kpzip/IEEEClock/README.md

# IEEEClock
Back to the future style clock
