kpzip/IEEEClock/new/pcb/1.1/clock.kicad_pcb

## KiCad design new/pcb/1.1/clock.kicad_pcb (2025-06-02)

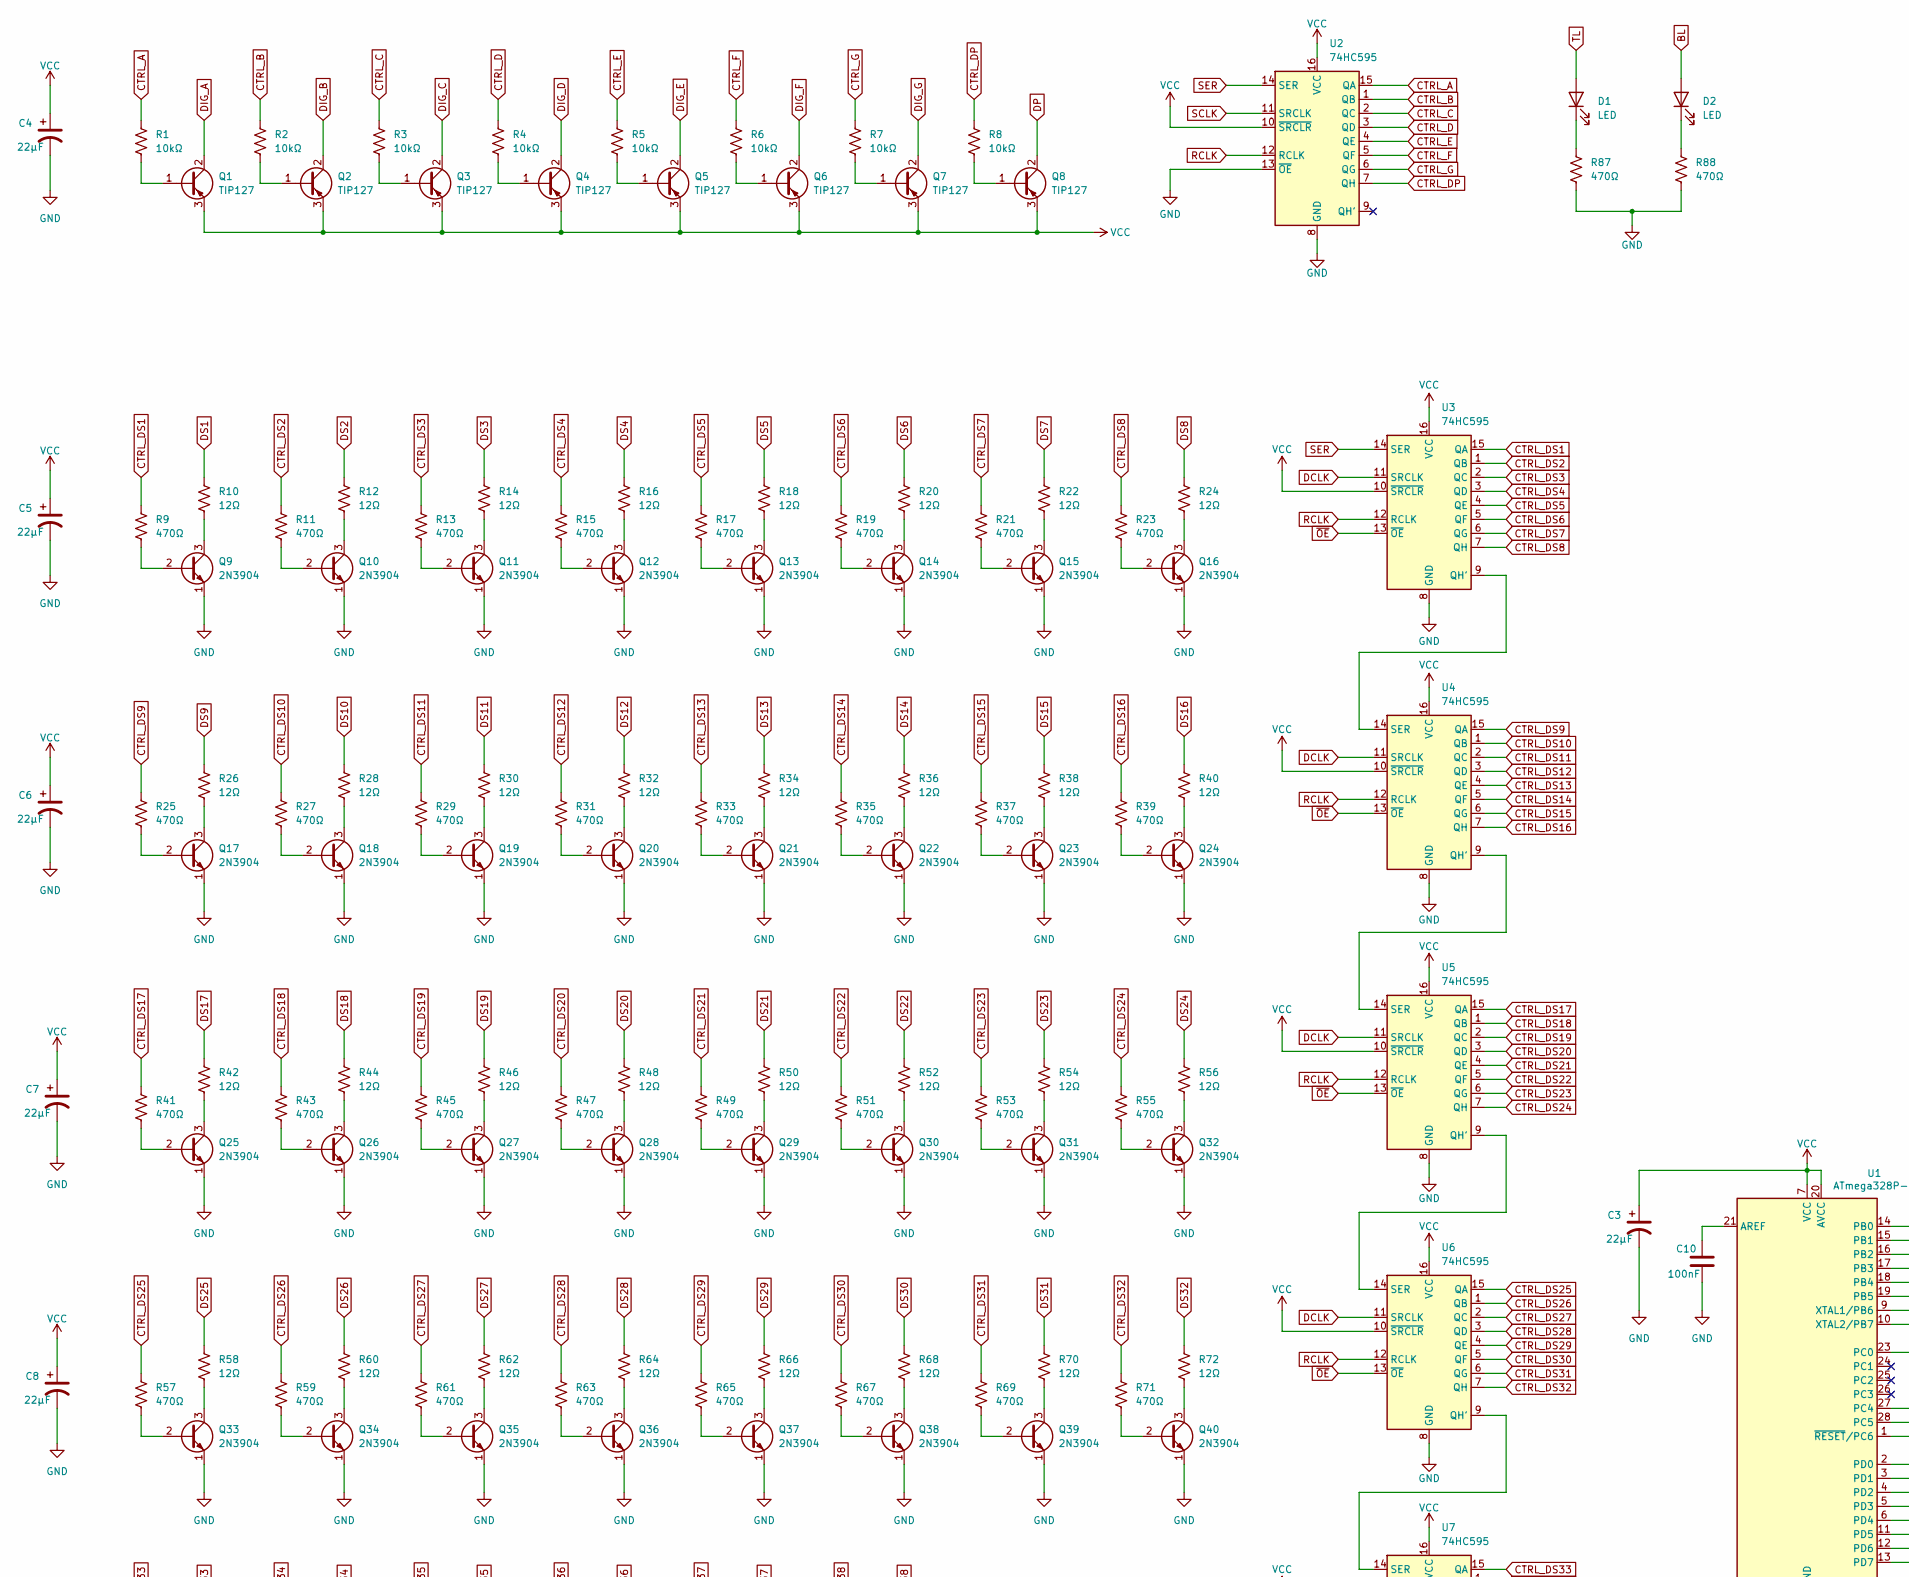
[picture p1: schematic clock.kicad_sch, IEEE Clock, part in row 1, column 1]

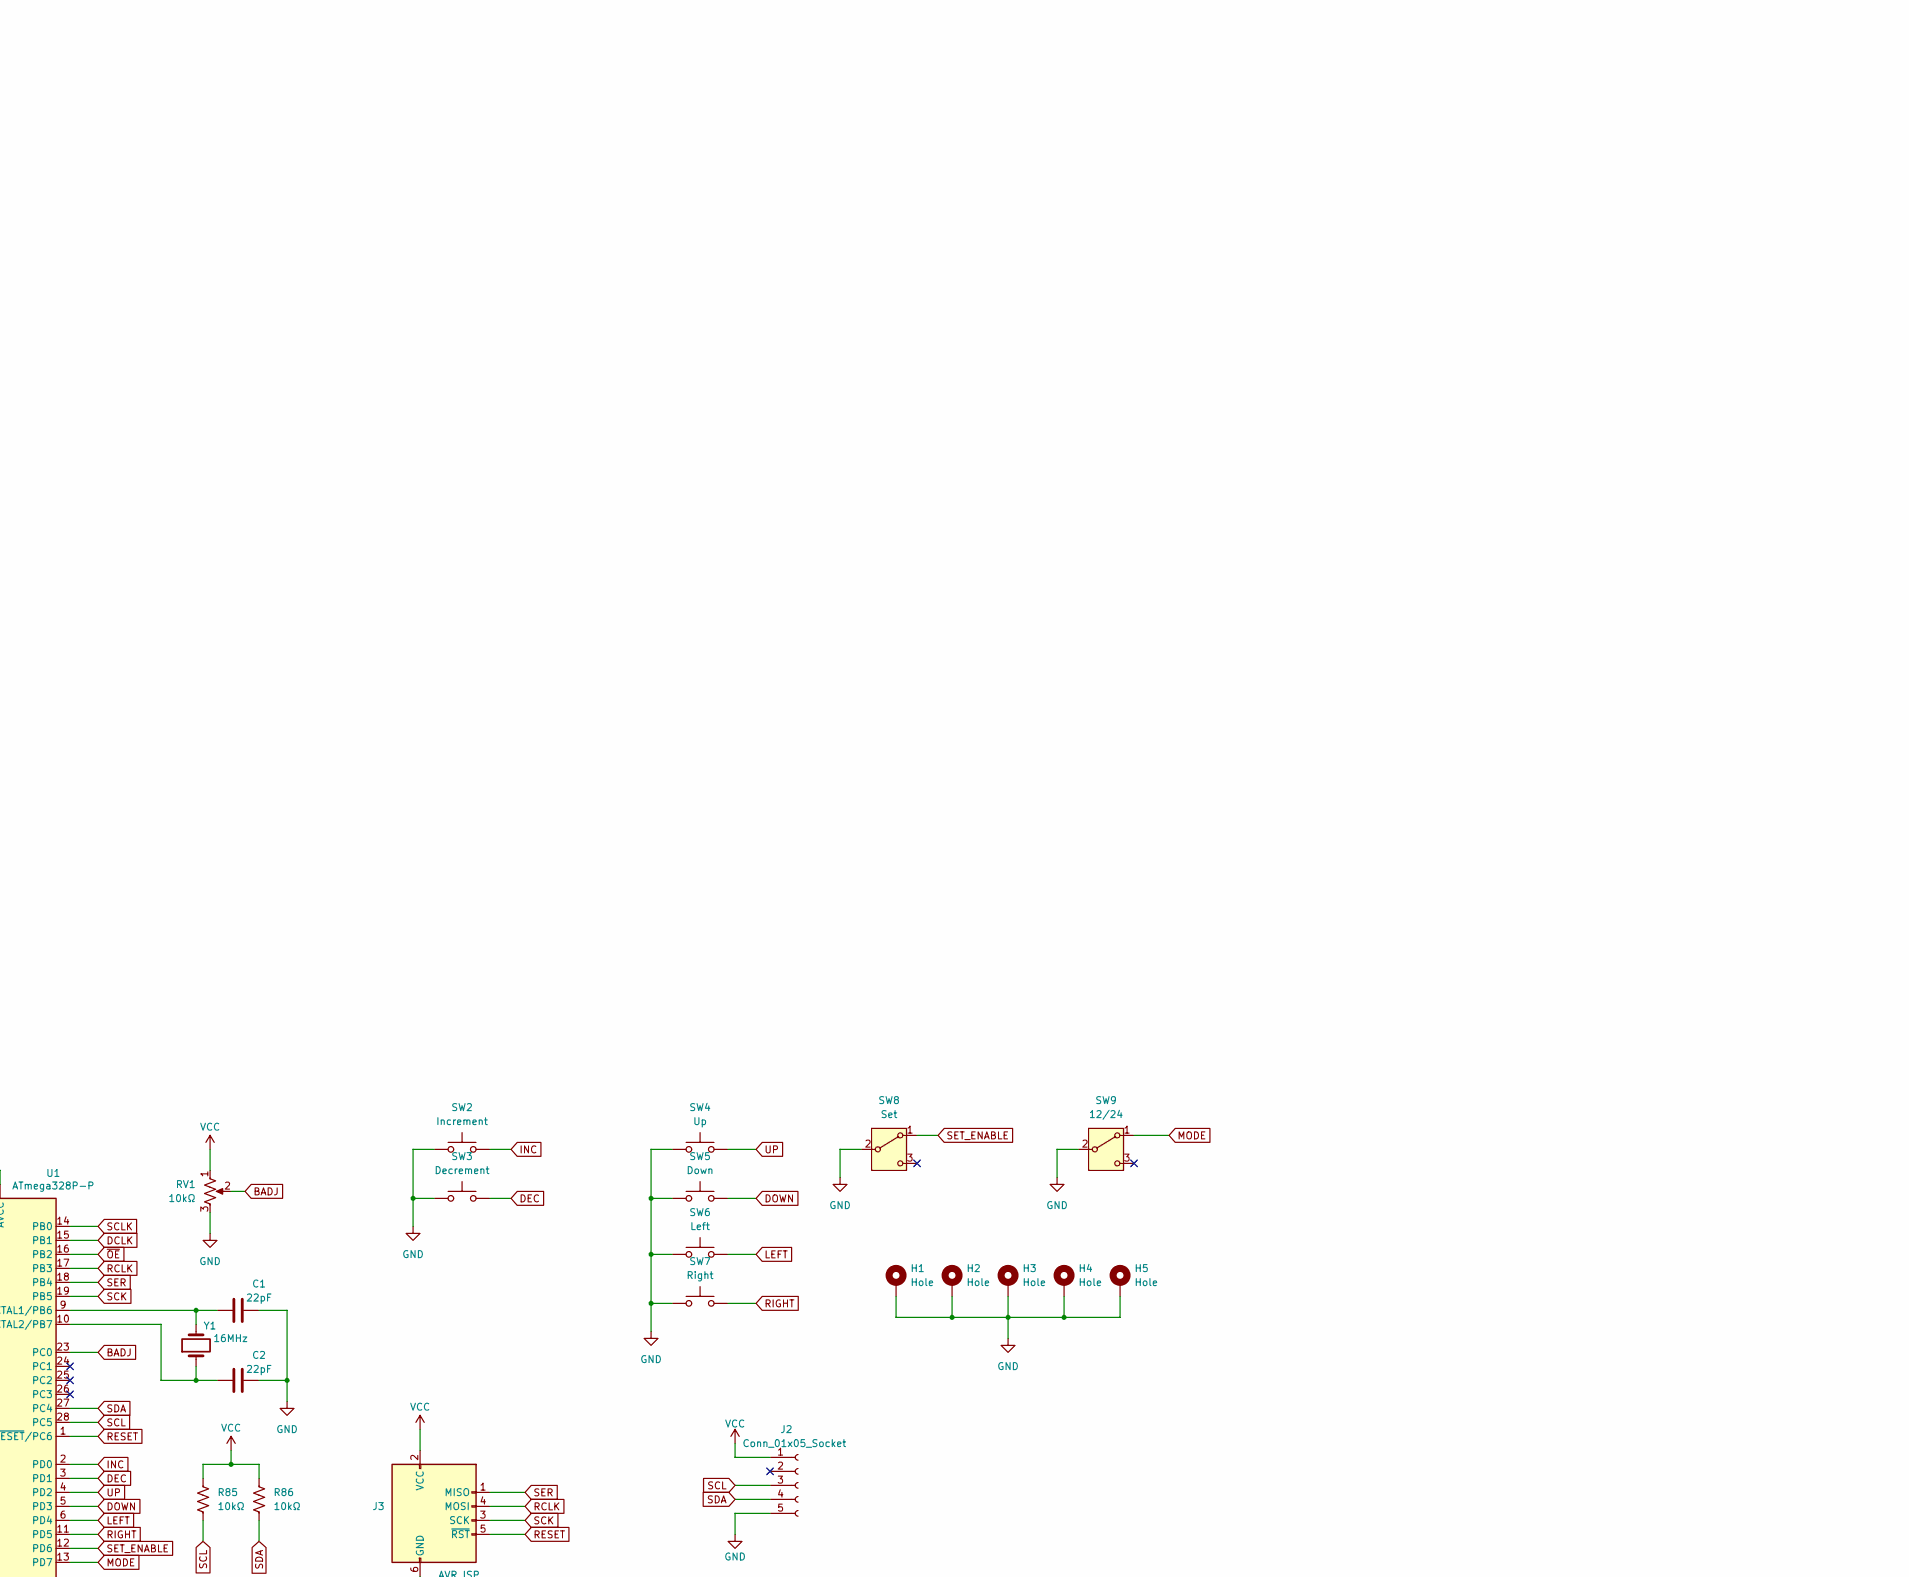
[picture p2: schematic clock.kicad_sch, IEEE Clock, part in row 1, column 2]

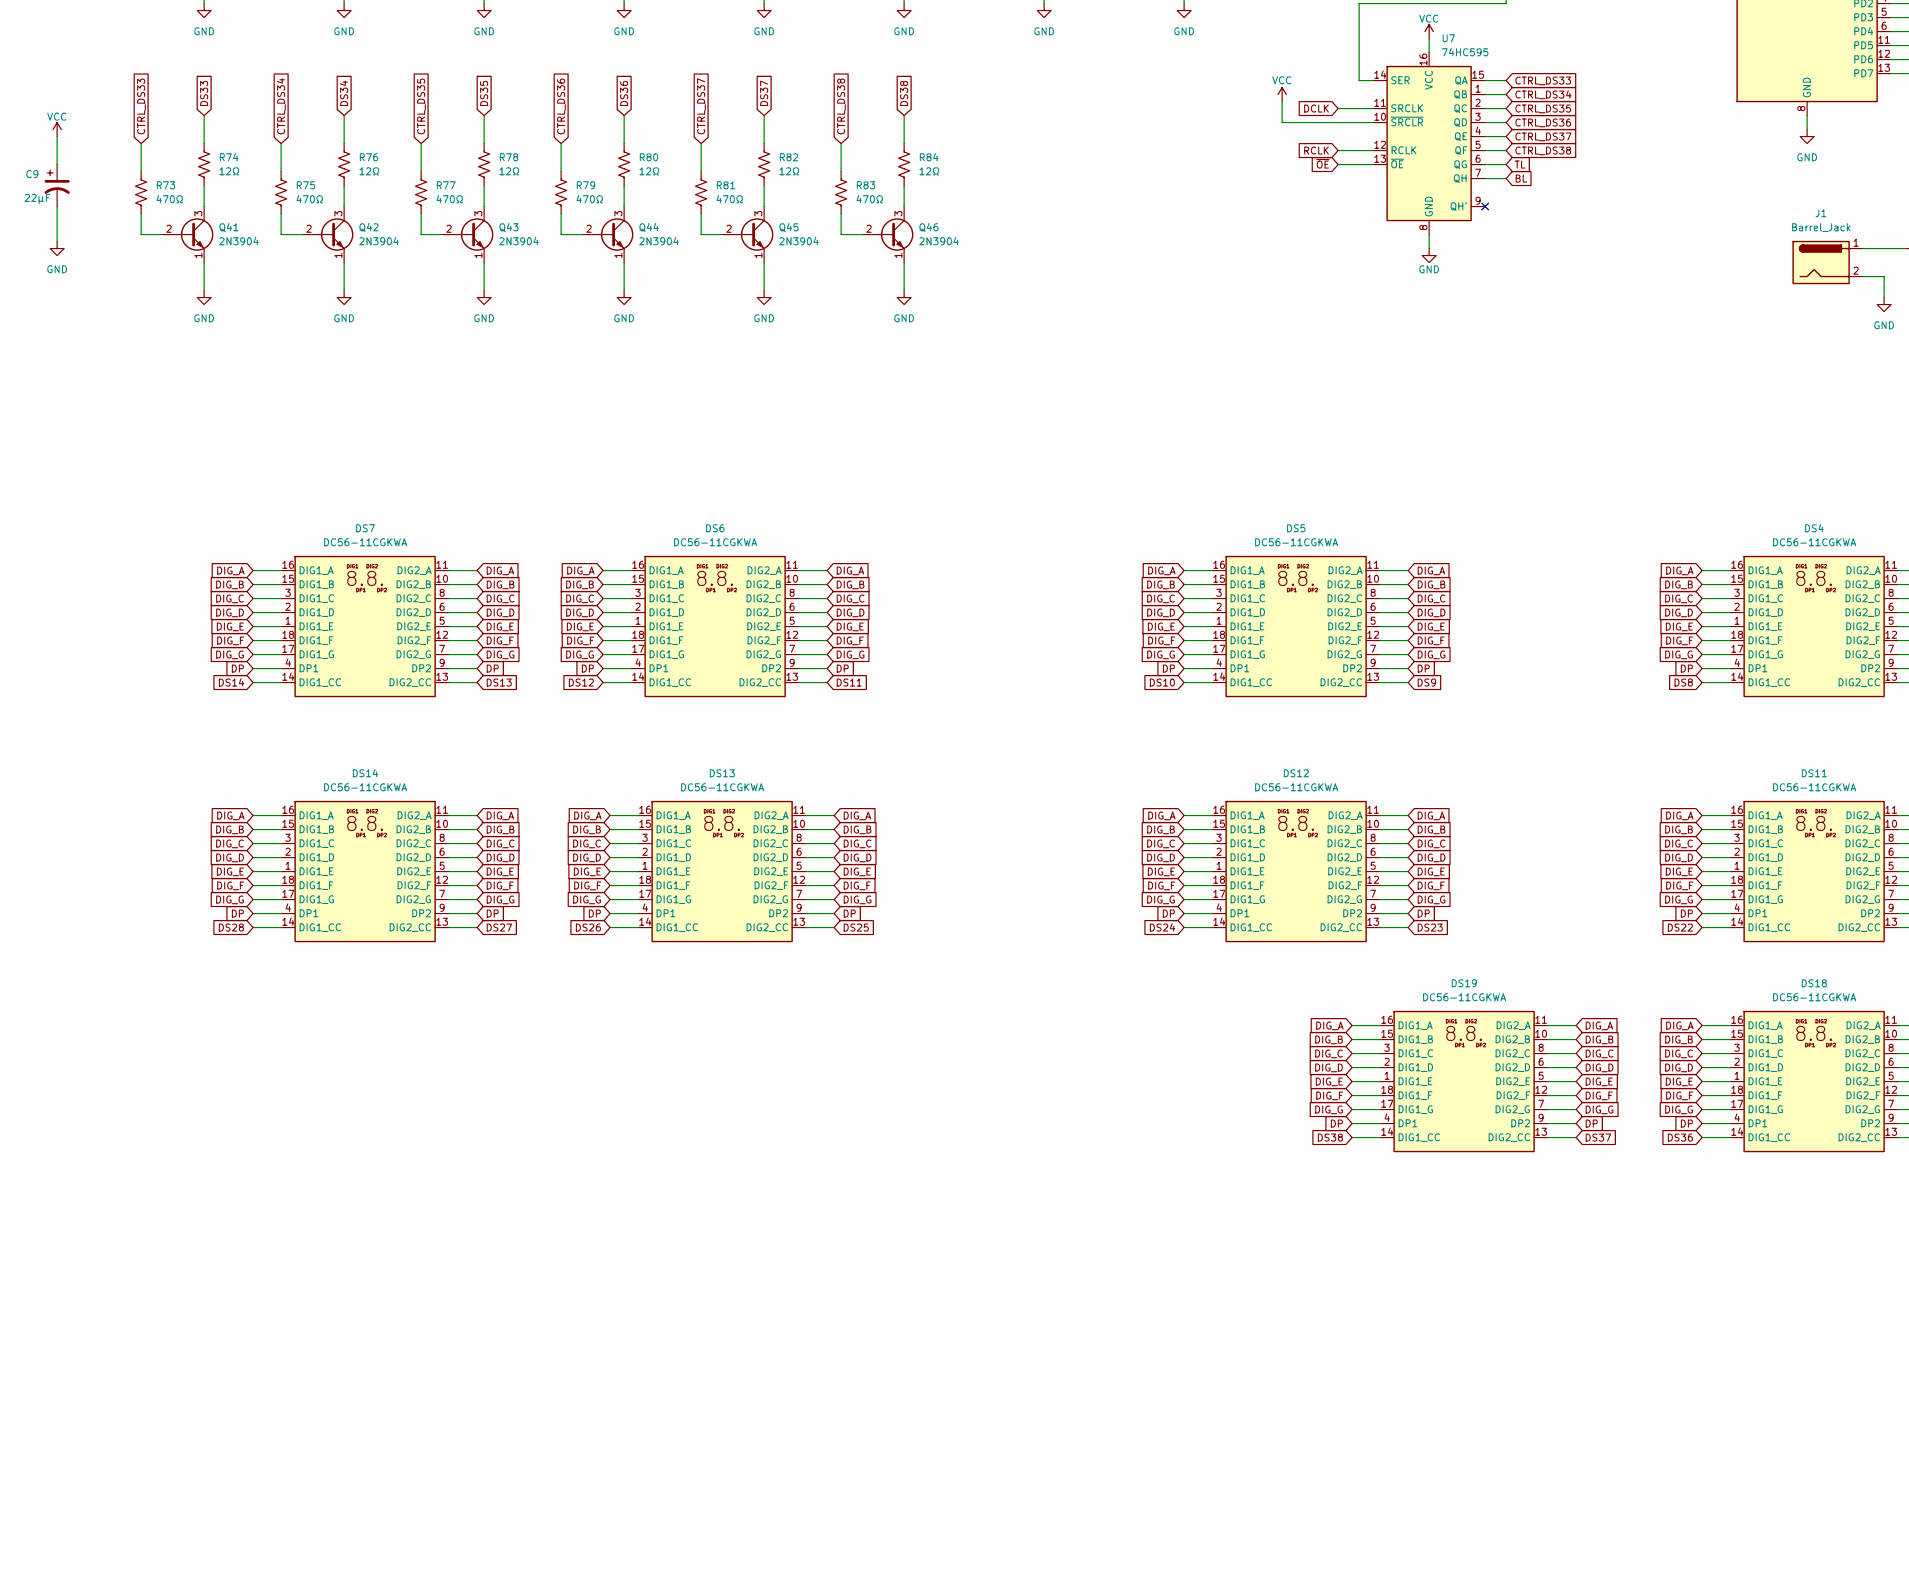
[picture p3: schematic clock.kicad_sch, IEEE Clock, part in row 2, column 1]

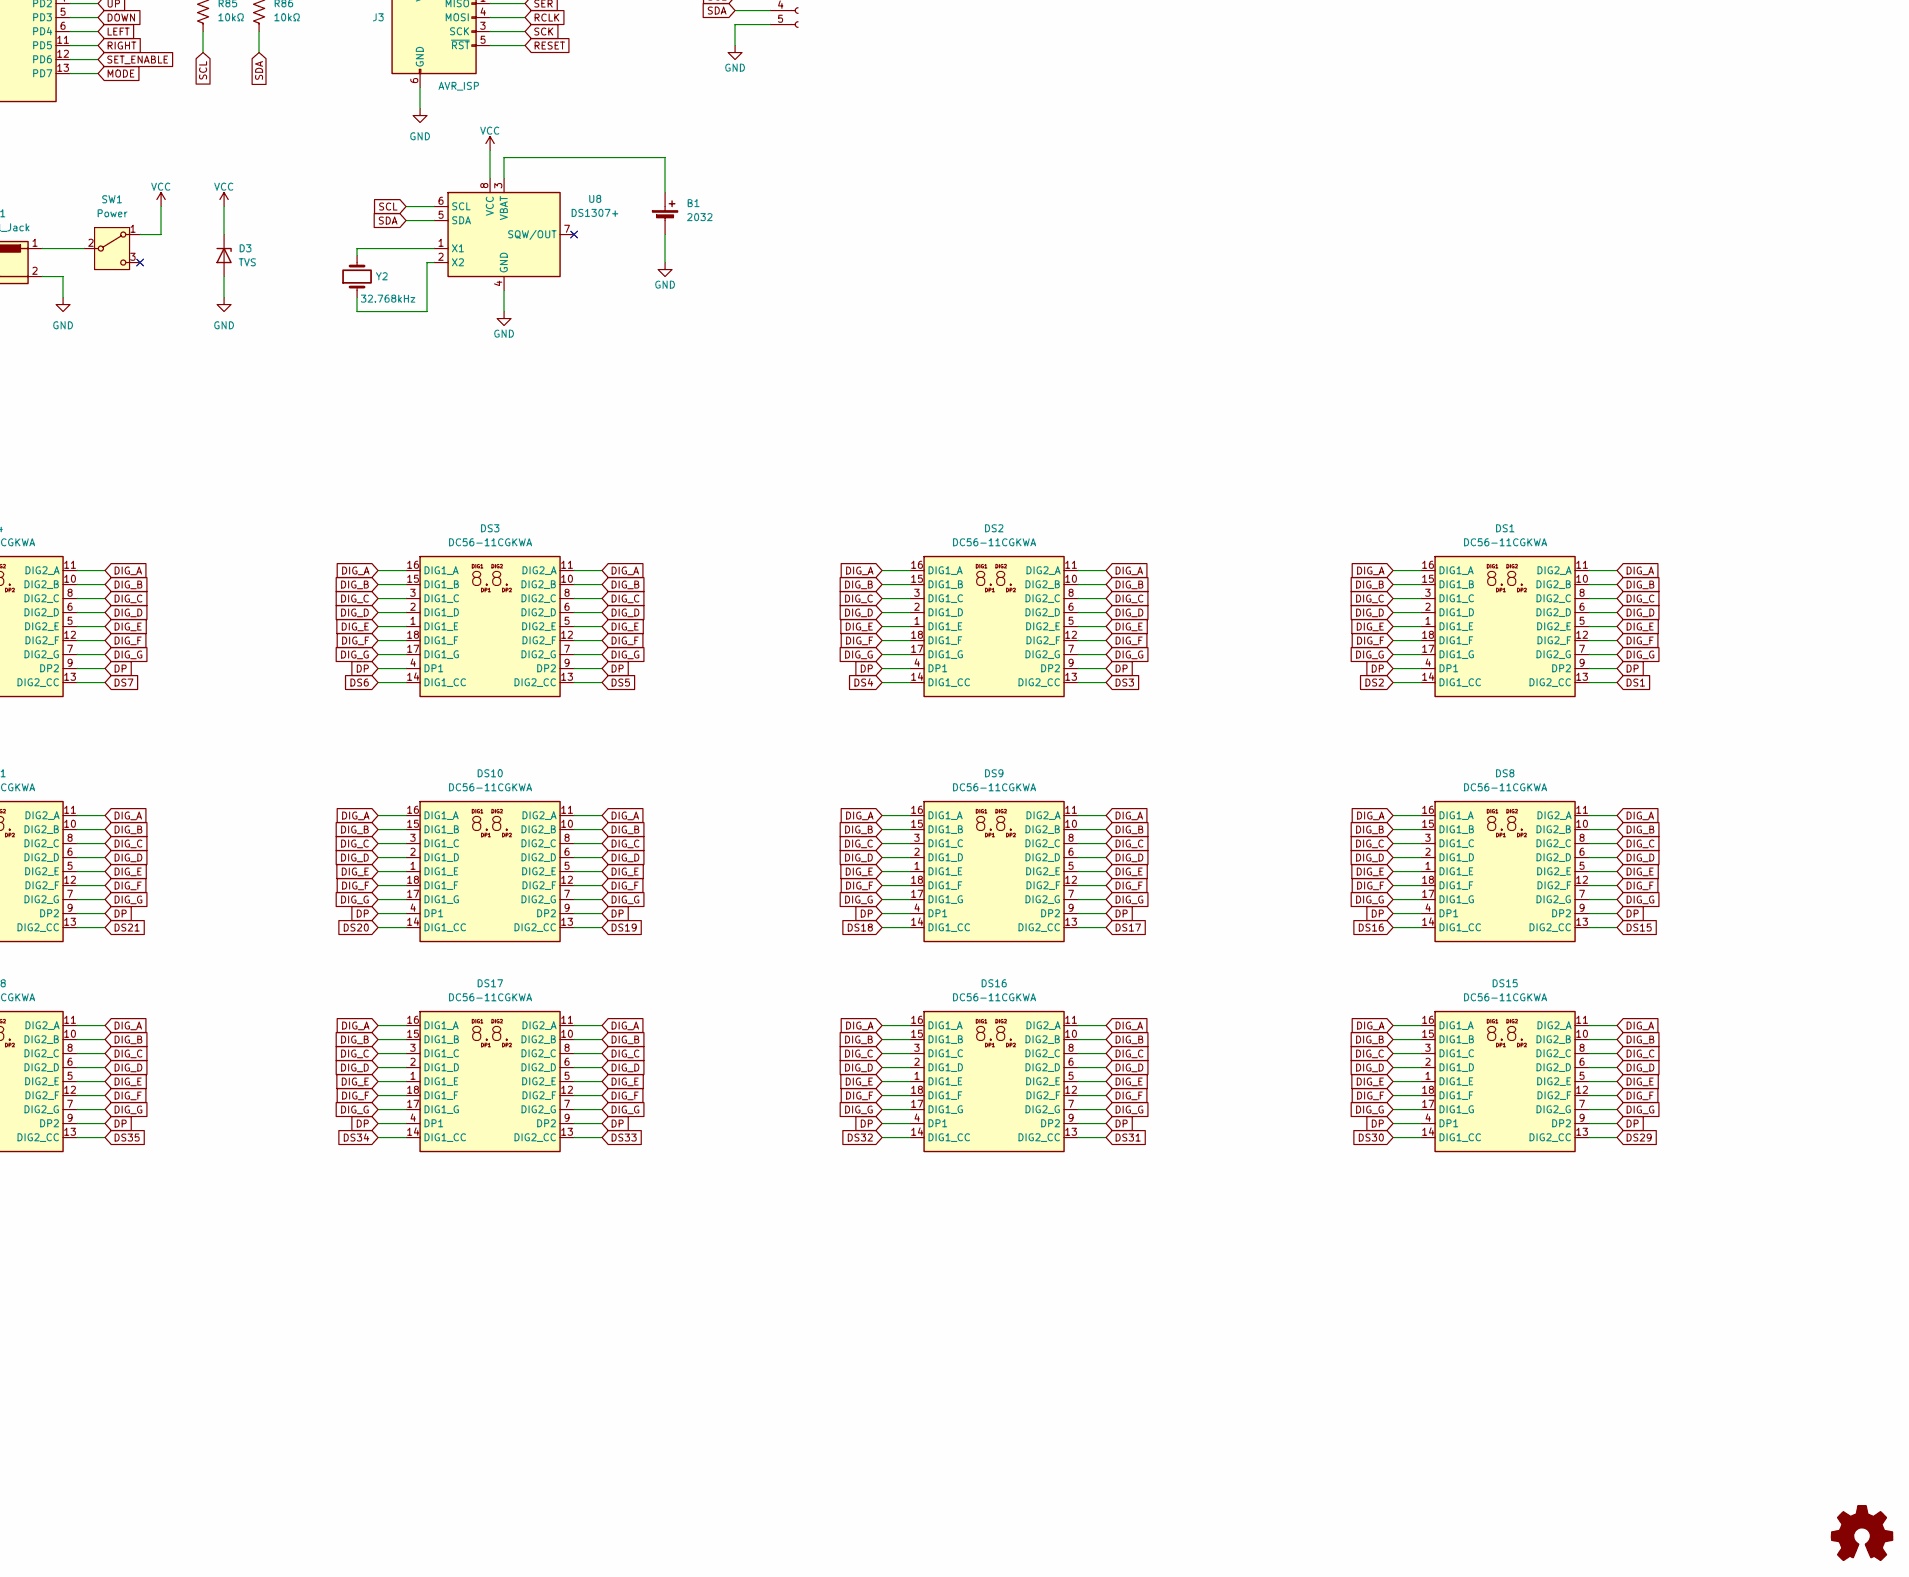
[picture p4: schematic clock.kicad_sch, IEEE Clock, part in row 2, column 2]

Parts:
B1: 2032; BAT_BAT-HLD-001-THM
C1, C2: 22pF; C_1206_3216Metric_Pad1.33x1.80mm_HandSolder
C3, C4, C5, C6, C7, C8, C9: 22μF; CP_Radial_D5.0mm_P2.00mm
C10: 100nF; C_1206_3216Metric_Pad1.33x1.80mm_HandSolder
D1, D2: LED; LED_D5.0mm
D3: TVS; D_SMA_Handsoldering
DS1, DS2, DS3, DS4, DS5, DS6, DS7, DS8, DS9, DS10, DS11, DS12, DS13, DS14, DS15, DS16, DS17, DS18, DS19: DC56-11CGKWA; DIPS2200W51P254L3580H1000Q18N
H1, H2, H3, H4, H5: Hole; MountingHole_2.2mm_M2_ISO7380_Pad
J1: Barrel_Jack; BarrelJack_GCT_DCJ200-10-A_Horizontal
J2: Conn_01x05_Socket; PinSocket_1x05_P2.54mm_Vertical
J3: AVR_ISP; IDC-Header_2x03_P2.54mm_Vertical
LG1: Logo_Open_Hardware_Small; UCSB_IEEE_Logo
Q1, Q2, Q3, Q4, Q5, Q6, Q7, Q8: TIP127; TO-220-3_Horizontal_TabDown
Q9, Q10, Q11, Q12, Q13, Q14, Q15, Q16, Q17, Q18, Q19, Q20, Q21, Q22, Q23, Q24, Q25, Q26, Q27, Q28, Q29, Q30, Q31, Q32, Q33, Q34, Q35, Q36, Q37, Q38, Q39, Q40, Q41, Q42, Q43, Q44, Q45, Q46: 2N3904; TO-92L_Inline
R1, R2, R3, R4, R5, R6, R7, R8, R85, R86: 10kΩ; R_Axial_DIN0207_L6.3mm_D2.5mm_P10.16mm_Horizontal
R9, R11, R13, R15, R17, R19, R21, R23, R25, R27, R29, R31, R33, R35, R37, R39, R41, R43, R45, R47, R49, R51, R53, R55, R57, R59, R61, R63, R65, R67, R69, R71, R73, R75, R77, R79, R81, R83, R87, R88: 470Ω; R_Axial_DIN0207_L6.3mm_D2.5mm_P10.16mm_Horizontal
R10, R12, R14, R16, R18, R20, R22, R24, R26, R28, R30, R32, R34, R36, R38, R40, R42, R44, R46, R48, R50, R52, R54, R56, R58, R60, R62, R64, R66, R68, R70, R72, R74, R76, R78, R80, R82, R84: 12Ω; R_Axial_DIN0207_L6.3mm_D2.5mm_P10.16mm_Horizontal
RV1: 10kΩ; Potentiometer_Bourns_PTV09A-1_Single_Vertical
SW1: Power; SW_Slide-03_Wuerth-WS-SLTV_10x2.5x6.4_P2.54mm
SW2: Increment; SW_PUSH_6mm
SW3: Decrement; SW_PUSH_6mm
SW4: Up; SW_PUSH_6mm
SW5: Down; SW_PUSH_6mm
SW6: Left; SW_PUSH_6mm
SW7: Right; SW_PUSH_6mm
SW8: Set; SW_Slide-03_Wuerth-WS-SLTV_10x2.5x6.4_P2.54mm
SW9: 12/24; SW_Slide-03_Wuerth-WS-SLTV_10x2.5x6.4_P2.54mm
U1: ATmega328P-P; DIP-28_W7.62mm_Socket_LongPads
U2, U3, U4, U5, U6, U7: 74HC595; DIP-16_W7.62mm_Socket_LongPads
U8: DS1307+; DIP-8_W7.62mm_Socket_LongPads
Y1: 16MHz; Crystal_HC49-U_Vertical
Y2: 32.768kHz; Crystal_DS10_D1.0mm_L4.3mm_Vertical

Connections:
BADJ: RV1.2, U1.23 (PC0)
BL: D2.2 (A), U7.7 (QH)
CTRL_A: R1.1, U2.15 (QA)
CTRL_B: R2.1, U2.1 (QB)
CTRL_C: R3.1, U2.2 (QC)
CTRL_D: R4.1, U2.3 (QD)
CTRL_DP: R8.1, U2.7 (QH)
CTRL_DS1: R9.1, U3.15 (QA)
CTRL_DS2: R11.1, U3.1 (QB)
CTRL_DS3: R13.1, U3.2 (QC)
CTRL_DS4: R15.1, U3.3 (QD)
CTRL_DS5: R17.1, U3.4 (QE)
CTRL_DS6: R19.1, U3.5 (QF)
CTRL_DS7: R21.1, U3.6 (QG)
CTRL_DS8: R23.1, U3.7 (QH)
CTRL_DS9: R25.1, U4.15 (QA)
CTRL_DS10: R27.1, U4.1 (QB)
CTRL_DS11: R29.1, U4.2 (QC)
CTRL_DS12: R31.1, U4.3 (QD)
CTRL_DS13: R33.1, U4.4 (QE)
CTRL_DS14: R35.1, U4.5 (QF)
CTRL_DS15: R37.1, U4.6 (QG)
CTRL_DS16: R39.1, U4.7 (QH)
CTRL_DS17: R41.1, U5.15 (QA)
CTRL_DS18: R43.1, U5.1 (QB)
CTRL_DS19: R45.1, U5.2 (QC)
CTRL_DS20: R47.1, U5.3 (QD)
CTRL_DS21: R49.1, U5.4 (QE)
CTRL_DS22: R51.1, U5.5 (QF)
CTRL_DS23: R53.1, U5.6 (QG)
CTRL_DS24: R55.1, U5.7 (QH)
CTRL_DS25: R57.1, U6.15 (QA)
CTRL_DS26: R59.1, U6.1 (QB)
CTRL_DS27: R61.1, U6.2 (QC)
CTRL_DS28: R63.1, U6.3 (QD)
CTRL_DS29: R65.1, U6.4 (QE)
CTRL_DS30: R67.1, U6.5 (QF)
CTRL_DS31: R69.1, U6.6 (QG)
CTRL_DS32: R71.1, U6.7 (QH)
CTRL_DS33: R73.1, U7.15 (QA)
CTRL_DS34: R75.1, U7.1 (QB)
CTRL_DS35: R77.1, U7.2 (QC)
CTRL_DS36: R79.1, U7.3 (QD)
CTRL_DS37: R81.1, U7.4 (QE)
CTRL_DS38: R83.1, U7.5 (QF)
CTRL_E: R5.1, U2.4 (QE)
CTRL_F: R6.1, U2.5 (QF)
CTRL_G: R7.1, U2.6 (QG)
DCLK: U1.15 (PB1), U3.11 (SRCLK), U4.11 (SRCLK), U5.11 (SRCLK), U6.11 (SRCLK), U7.11 (SRCLK)
DEC: SW3.2, U1.3 (PD1)
DIG_A: DS1.11 (DIG2_A), DS1.16 (DIG1_A), DS2.11 (DIG2_A), DS2.16 (DIG1_A), DS3.11 (DIG2_A), DS3.16 (DIG1_A), DS4.11 (DIG2_A), DS4.16 (DIG1_A), DS5.11 (DIG2_A), DS5.16 (DIG1_A), DS6.11 (DIG2_A), DS6.16 (DIG1_A), DS7.11 (DIG2_A), DS7.16 (DIG1_A), DS8.11 (DIG2_A), DS8.16 (DIG1_A), DS9.11 (DIG2_A), DS9.16 (DIG1_A), DS10.11 (DIG2_A), DS10.16 (DIG1_A), DS11.11 (DIG2_A), DS11.16 (DIG1_A), DS12.11 (DIG2_A), DS12.16 (DIG1_A), DS13.11 (DIG2_A), DS13.16 (DIG1_A), DS14.11 (DIG2_A), DS14.16 (DIG1_A), DS15.11 (DIG2_A), DS15.16 (DIG1_A), DS16.11 (DIG2_A), DS16.16 (DIG1_A), DS17.11 (DIG2_A), DS17.16 (DIG1_A), DS18.11 (DIG2_A), DS18.16 (DIG1_A), DS19.11 (DIG2_A), DS19.16 (DIG1_A), Q1.2 (C)
DIG_B: DS1.10 (DIG2_B), DS1.15 (DIG1_B), DS2.10 (DIG2_B), DS2.15 (DIG1_B), DS3.10 (DIG2_B), DS3.15 (DIG1_B), DS4.10 (DIG2_B), DS4.15 (DIG1_B), DS5.10 (DIG2_B), DS5.15 (DIG1_B), DS6.10 (DIG2_B), DS6.15 (DIG1_B), DS7.10 (DIG2_B), DS7.15 (DIG1_B), DS8.10 (DIG2_B), DS8.15 (DIG1_B), DS9.10 (DIG2_B), DS9.15 (DIG1_B), DS10.10 (DIG2_B), DS10.15 (DIG1_B), DS11.10 (DIG2_B), DS11.15 (DIG1_B), DS12.10 (DIG2_B), DS12.15 (DIG1_B), DS13.10 (DIG2_B), DS13.15 (DIG1_B), DS14.10 (DIG2_B), DS14.15 (DIG1_B), DS15.10 (DIG2_B), DS15.15 (DIG1_B), DS16.10 (DIG2_B), DS16.15 (DIG1_B), DS17.10 (DIG2_B), DS17.15 (DIG1_B), DS18.10 (DIG2_B), DS18.15 (DIG1_B), DS19.10 (DIG2_B), DS19.15 (DIG1_B), Q2.2 (C)
DIG_C: DS1.3 (DIG1_C), DS1.8 (DIG2_C), DS2.3 (DIG1_C), DS2.8 (DIG2_C), DS3.3 (DIG1_C), DS3.8 (DIG2_C), DS4.3 (DIG1_C), DS4.8 (DIG2_C), DS5.3 (DIG1_C), DS5.8 (DIG2_C), DS6.3 (DIG1_C), DS6.8 (DIG2_C), DS7.3 (DIG1_C), DS7.8 (DIG2_C), DS8.3 (DIG1_C), DS8.8 (DIG2_C), DS9.3 (DIG1_C), DS9.8 (DIG2_C), DS10.3 (DIG1_C), DS10.8 (DIG2_C), DS11.3 (DIG1_C), DS11.8 (DIG2_C), DS12.3 (DIG1_C), DS12.8 (DIG2_C), DS13.3 (DIG1_C), DS13.8 (DIG2_C), DS14.3 (DIG1_C), DS14.8 (DIG2_C), DS15.3 (DIG1_C), DS15.8 (DIG2_C), DS16.3 (DIG1_C), DS16.8 (DIG2_C), DS17.3 (DIG1_C), DS17.8 (DIG2_C), DS18.3 (DIG1_C), DS18.8 (DIG2_C), DS19.3 (DIG1_C), DS19.8 (DIG2_C), Q3.2 (C)
DIG_D: DS1.2 (DIG1_D), DS1.6 (DIG2_D), DS2.2 (DIG1_D), DS2.6 (DIG2_D), DS3.2 (DIG1_D), DS3.6 (DIG2_D), DS4.2 (DIG1_D), DS4.6 (DIG2_D), DS5.2 (DIG1_D), DS5.6 (DIG2_D), DS6.2 (DIG1_D), DS6.6 (DIG2_D), DS7.2 (DIG1_D), DS7.6 (DIG2_D), DS8.2 (DIG1_D), DS8.6 (DIG2_D), DS9.2 (DIG1_D), DS9.6 (DIG2_D), DS10.2 (DIG1_D), DS10.6 (DIG2_D), DS11.2 (DIG1_D), DS11.6 (DIG2_D), DS12.2 (DIG1_D), DS12.6 (DIG2_D), DS13.2 (DIG1_D), DS13.6 (DIG2_D), DS14.2 (DIG1_D), DS14.6 (DIG2_D), DS15.2 (DIG1_D), DS15.6 (DIG2_D), DS16.2 (DIG1_D), DS16.6 (DIG2_D), DS17.2 (DIG1_D), DS17.6 (DIG2_D), DS18.2 (DIG1_D), DS18.6 (DIG2_D), DS19.2 (DIG1_D), DS19.6 (DIG2_D), Q4.2 (C)
DIG_E: DS1.1 (DIG1_E), DS1.5 (DIG2_E), DS2.1 (DIG1_E), DS2.5 (DIG2_E), DS3.1 (DIG1_E), DS3.5 (DIG2_E), DS4.1 (DIG1_E), DS4.5 (DIG2_E), DS5.1 (DIG1_E), DS5.5 (DIG2_E), DS6.1 (DIG1_E), DS6.5 (DIG2_E), DS7.1 (DIG1_E), DS7.5 (DIG2_E), DS8.1 (DIG1_E), DS8.5 (DIG2_E), DS9.1 (DIG1_E), DS9.5 (DIG2_E), DS10.1 (DIG1_E), DS10.5 (DIG2_E), DS11.1 (DIG1_E), DS11.5 (DIG2_E), DS12.1 (DIG1_E), DS12.5 (DIG2_E), DS13.1 (DIG1_E), DS13.5 (DIG2_E), DS14.1 (DIG1_E), DS14.5 (DIG2_E), DS15.1 (DIG1_E), DS15.5 (DIG2_E), DS16.1 (DIG1_E), DS16.5 (DIG2_E), DS17.1 (DIG1_E), DS17.5 (DIG2_E), DS18.1 (DIG1_E), DS18.5 (DIG2_E), DS19.1 (DIG1_E), DS19.5 (DIG2_E), Q5.2 (C)
DIG_F: DS1.12 (DIG2_F), DS1.18 (DIG1_F), DS2.12 (DIG2_F), DS2.18 (DIG1_F), DS3.12 (DIG2_F), DS3.18 (DIG1_F), DS4.12 (DIG2_F), DS4.18 (DIG1_F), DS5.12 (DIG2_F), DS5.18 (DIG1_F), DS6.12 (DIG2_F), DS6.18 (DIG1_F), DS7.12 (DIG2_F), DS7.18 (DIG1_F), DS8.12 (DIG2_F), DS8.18 (DIG1_F), DS9.12 (DIG2_F), DS9.18 (DIG1_F), DS10.12 (DIG2_F), DS10.18 (DIG1_F), DS11.12 (DIG2_F), DS11.18 (DIG1_F), DS12.12 (DIG2_F), DS12.18 (DIG1_F), DS13.12 (DIG2_F), DS13.18 (DIG1_F), DS14.12 (DIG2_F), DS14.18 (DIG1_F), DS15.12 (DIG2_F), DS15.18 (DIG1_F), DS16.12 (DIG2_F), DS16.18 (DIG1_F), DS17.12 (DIG2_F), DS17.18 (DIG1_F), DS18.12 (DIG2_F), DS18.18 (DIG1_F), DS19.12 (DIG2_F), DS19.18 (DIG1_F), Q6.2 (C)
DIG_G: DS1.7 (DIG2_G), DS1.17 (DIG1_G), DS2.7 (DIG2_G), DS2.17 (DIG1_G), DS3.7 (DIG2_G), DS3.17 (DIG1_G), DS4.7 (DIG2_G), DS4.17 (DIG1_G), DS5.7 (DIG2_G), DS5.17 (DIG1_G), DS6.7 (DIG2_G), DS6.17 (DIG1_G), DS7.7 (DIG2_G), DS7.17 (DIG1_G), DS8.7 (DIG2_G), DS8.17 (DIG1_G), DS9.7 (DIG2_G), DS9.17 (DIG1_G), DS10.7 (DIG2_G), DS10.17 (DIG1_G), DS11.7 (DIG2_G), DS11.17 (DIG1_G), DS12.7 (DIG2_G), DS12.17 (DIG1_G), DS13.7 (DIG2_G), DS13.17 (DIG1_G), DS14.7 (DIG2_G), DS14.17 (DIG1_G), DS15.7 (DIG2_G), DS15.17 (DIG1_G), DS16.7 (DIG2_G), DS16.17 (DIG1_G), DS17.7 (DIG2_G), DS17.17 (DIG1_G), DS18.7 (DIG2_G), DS18.17 (DIG1_G), DS19.7 (DIG2_G), DS19.17 (DIG1_G), Q7.2 (C)
DOWN: SW5.2, U1.5 (PD3)
DP: DS1.4 (DP1), DS1.9 (DP2), DS2.4 (DP1), DS2.9 (DP2), DS3.4 (DP1), DS3.9 (DP2), DS4.4 (DP1), DS4.9 (DP2), DS5.4 (DP1), DS5.9 (DP2), DS6.4 (DP1), DS6.9 (DP2), DS7.4 (DP1), DS7.9 (DP2), DS8.4 (DP1), DS8.9 (DP2), DS9.4 (DP1), DS9.9 (DP2), DS10.4 (DP1), DS10.9 (DP2), DS11.4 (DP1), DS11.9 (DP2), DS12.4 (DP1), DS12.9 (DP2), DS13.4 (DP1), DS13.9 (DP2), DS14.4 (DP1), DS14.9 (DP2), DS15.4 (DP1), DS15.9 (DP2), DS16.4 (DP1), DS16.9 (DP2), DS17.4 (DP1), DS17.9 (DP2), DS18.4 (DP1), DS18.9 (DP2), DS19.4 (DP1), DS19.9 (DP2), Q8.2 (C)
DS1: DS1.13 (DIG2_CC), R10.1
DS2: DS1.14 (DIG1_CC), R12.1
DS3: DS2.13 (DIG2_CC), R14.1
DS4: DS2.14 (DIG1_CC), R16.1
DS5: DS3.13 (DIG2_CC), R18.1
DS6: DS3.14 (DIG1_CC), R20.1
DS7: DS4.13 (DIG2_CC), R22.1
DS8: DS4.14 (DIG1_CC), R24.1
DS9: DS5.13 (DIG2_CC), R26.1
DS10: DS5.14 (DIG1_CC), R28.1
DS11: DS6.13 (DIG2_CC), R30.1
DS12: DS6.14 (DIG1_CC), R32.1
DS13: DS7.13 (DIG2_CC), R34.1
DS14: DS7.14 (DIG1_CC), R36.1
DS15: DS8.13 (DIG2_CC), R38.1
DS16: DS8.14 (DIG1_CC), R40.1
DS17: DS9.13 (DIG2_CC), R42.1
DS18: DS9.14 (DIG1_CC), R44.1
DS19: DS10.13 (DIG2_CC), R46.1
DS20: DS10.14 (DIG1_CC), R48.1
DS21: DS11.13 (DIG2_CC), R50.1
DS22: DS11.14 (DIG1_CC), R52.1
DS23: DS12.13 (DIG2_CC), R54.1
DS24: DS12.14 (DIG1_CC), R56.1
DS25: DS13.13 (DIG2_CC), R58.1
DS26: DS13.14 (DIG1_CC), R60.1
DS27: DS14.13 (DIG2_CC), R62.1
DS28: DS14.14 (DIG1_CC), R64.1
DS29: DS15.13 (DIG2_CC), R66.1
DS30: DS15.14 (DIG1_CC), R68.1
DS31: DS16.13 (DIG2_CC), R70.1
DS32: DS16.14 (DIG1_CC), R72.1
DS33: DS17.13 (DIG2_CC), R74.1
DS34: DS17.14 (DIG1_CC), R76.1
DS35: DS18.13 (DIG2_CC), R78.1
DS36: DS18.14 (DIG1_CC), R80.1
DS37: DS19.13 (DIG2_CC), R82.1
DS38: DS19.14 (DIG1_CC), R84.1
GND: B1.2 (-), C1.2, C2.2, C3.2, C4.2, C5.2, C6.2, C7.2, C8.2, C9.2, C10.2, D3.2 (A), H1.1, H2.1, H3.1, H4.1, H5.1, J1.2, J2.5, J3.6 (GND), Q9.1 (E), Q10.1 (E), Q11.1 (E), Q12.1 (E), Q13.1 (E), Q14.1 (E), Q15.1 (E), Q16.1 (E), Q17.1 (E), Q18.1 (E), Q19.1 (E), Q20.1 (E), Q21.1 (E), Q22.1 (E), Q23.1 (E), Q24.1 (E), Q25.1 (E), Q26.1 (E), Q27.1 (E), Q28.1 (E), Q29.1 (E), Q30.1 (E), Q31.1 (E), Q32.1 (E), Q33.1 (E), Q34.1 (E), Q35.1 (E), Q36.1 (E), Q37.1 (E), Q38.1 (E), Q39.1 (E), Q40.1 (E), Q41.1 (E), Q42.1 (E), Q43.1 (E), Q44.1 (E), Q45.1 (E), Q46.1 (E), R87.2, R88.2, RV1.3, SW2.1, SW3.1, SW4.1, SW5.1, SW6.1, SW7.1, SW8.2 (B), SW9.2 (B), U1.8 (GND), U1.22 (GND), U2.8 (GND), U2.13 (~OE), U3.8 (GND), U4.8 (GND), U5.8 (GND), U6.8 (GND), U7.8 (GND), U8.4 (GND)
INC: SW2.2, U1.2 (PD0)
LEFT: SW6.2, U1.6 (PD4)
MODE: SW9.1 (A), U1.13 (PD7)
unnamed: B1.1 (+), U8.3 (VBAT)
unnamed: D1.1 (K), R87.1
unnamed: D2.1 (K), R88.1
unnamed: Q1.1 (B), R1.2
unnamed: Q2.1 (B), R2.2
unnamed: Q3.1 (B), R3.2
unnamed: Q4.1 (B), R4.2
unnamed: Q5.1 (B), R5.2
unnamed: Q6.1 (B), R6.2
unnamed: Q7.1 (B), R7.2
unnamed: Q8.1 (B), R8.2
unnamed: Q9.2 (B), R9.2
unnamed: Q9.3 (C), R10.2
unnamed: Q10.2 (B), R11.2
unnamed: Q10.3 (C), R12.2
unnamed: Q11.2 (B), R13.2
unnamed: Q11.3 (C), R14.2
unnamed: Q12.2 (B), R15.2
unnamed: Q12.3 (C), R16.2
unnamed: Q13.2 (B), R17.2
unnamed: Q13.3 (C), R18.2
unnamed: Q14.2 (B), R19.2
unnamed: Q14.3 (C), R20.2
unnamed: Q15.2 (B), R21.2
unnamed: Q15.3 (C), R22.2
unnamed: Q16.2 (B), R23.2
unnamed: Q16.3 (C), R24.2
unnamed: Q17.2 (B), R25.2
unnamed: Q17.3 (C), R26.2
unnamed: Q18.2 (B), R27.2
unnamed: Q18.3 (C), R28.2
unnamed: Q19.2 (B), R29.2
unnamed: Q19.3 (C), R30.2
unnamed: Q20.2 (B), R31.2
unnamed: Q20.3 (C), R32.2
unnamed: Q21.2 (B), R33.2
unnamed: Q21.3 (C), R34.2
unnamed: Q22.2 (B), R35.2
unnamed: Q22.3 (C), R36.2
unnamed: Q23.2 (B), R37.2
unnamed: Q23.3 (C), R38.2
unnamed: Q24.2 (B), R39.2
unnamed: Q24.3 (C), R40.2
unnamed: Q25.2 (B), R41.2
unnamed: Q25.3 (C), R42.2
unnamed: Q26.2 (B), R43.2
unnamed: Q26.3 (C), R44.2
unnamed: Q27.2 (B), R45.2
unnamed: Q27.3 (C), R46.2
unnamed: Q28.2 (B), R47.2
unnamed: Q28.3 (C), R48.2
unnamed: Q29.2 (B), R49.2
unnamed: Q29.3 (C), R50.2
unnamed: Q30.2 (B), R51.2
unnamed: Q30.3 (C), R52.2
unnamed: Q31.2 (B), R53.2
unnamed: Q31.3 (C), R54.2
unnamed: Q32.2 (B), R55.2
unnamed: Q32.3 (C), R56.2
unnamed: Q33.2 (B), R57.2
unnamed: Q33.3 (C), R58.2
unnamed: Q34.2 (B), R59.2
unnamed: Q34.3 (C), R60.2
unnamed: Q35.2 (B), R61.2
unnamed: Q35.3 (C), R62.2
unnamed: Q36.2 (B), R63.2
unnamed: Q36.3 (C), R64.2
unnamed: Q37.2 (B), R65.2
unnamed: Q37.3 (C), R66.2
unnamed: Q38.2 (B), R67.2
unnamed: Q38.3 (C), R68.2
unnamed: Q39.2 (B), R69.2
unnamed: Q39.3 (C), R70.2
unnamed: Q40.2 (B), R71.2
unnamed: Q40.3 (C), R72.2
unnamed: Q41.2 (B), R73.2
unnamed: Q41.3 (C), R74.2
unnamed: Q42.2 (B), R75.2
unnamed: Q42.3 (C), R76.2
unnamed: Q43.2 (B), R77.2
unnamed: Q43.3 (C), R78.2
unnamed: Q44.2 (B), R79.2
unnamed: Q44.3 (C), R80.2
unnamed: Q45.2 (B), R81.2
unnamed: Q45.3 (C), R82.2
unnamed: Q46.2 (B), R83.2
unnamed: Q46.3 (C), R84.2
unnamed: J1.1, SW1.2 (B)
unnamed: C10.1, U1.21 (AREF)
unnamed: C1.1, U1.9 (XTAL1/PB6), Y1.2
unnamed: C2.1, U1.10 (XTAL2/PB7), Y1.1
unnamed: U3.9 (QH'), U4.14 (SER)
unnamed: U4.9 (QH'), U5.14 (SER)
unnamed: U5.9 (QH'), U6.14 (SER)
unnamed: U6.9 (QH'), U7.14 (SER)
unnamed: U8.1 (X1), Y2.2
unnamed: U8.2 (X2), Y2.1
RCLK: J3.4 (MOSI), U1.17 (PB3), U2.12 (RCLK), U3.12 (RCLK), U4.12 (RCLK), U5.12 (RCLK), U6.12 (RCLK), U7.12 (RCLK)
RESET: J3.5 (~RST), U1.1 (~RESET/PC6)
RIGHT: SW7.2, U1.11 (PD5)
SCK: J3.3 (SCK), U1.19 (PB5)
SCL: J2.3, R85.2, U1.28 (PC5), U8.6 (SCL)
SCLK: U1.14 (PB0), U2.11 (SRCLK)
SDA: J2.4, R86.2, U1.27 (PC4), U8.5 (SDA)
SER: J3.1 (MISO), U1.18 (PB4), U2.14 (SER), U3.14 (SER)
SET_ENABLE: SW8.1 (A), U1.12 (PD6)
TL: D1.2 (A), U7.6 (QG)
UP: SW4.2, U1.4 (PD2)
VCC: C3.1, C4.1, C5.1, C6.1, C7.1, C8.1, C9.1, D3.1 (K), J2.1, J3.2 (VCC), Q1.3 (E), Q2.3 (E), Q3.3 (E), Q4.3 (E), Q5.3 (E), Q6.3 (E), Q7.3 (E), Q8.3 (E), R85.1, R86.1, RV1.1, SW1.1 (A), U1.7 (VCC), U1.20 (AVCC), U2.10 (~SRCLR), U2.16 (VCC), U3.10 (~SRCLR), U3.16 (VCC), U4.10 (~SRCLR), U4.16 (VCC), U5.10 (~SRCLR), U5.16 (VCC), U6.10 (~SRCLR), U6.16 (VCC), U7.10 (~SRCLR), U7.16 (VCC), U8.8 (VCC)
~OE: U1.16 (PB2), U3.13 (~OE), U4.13 (~OE), U5.13 (~OE), U6.13 (~OE), U7.13 (~OE)

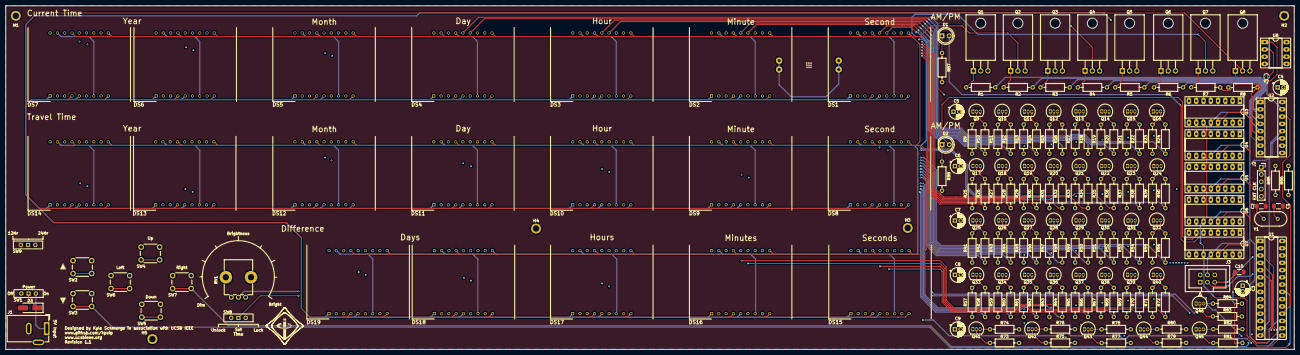
[picture p5: board clock.kicad_pcb from above]

Board: 4 copper layers, 450.0 x 120.0 mm, 196 parts (1 on the bottom side), 211 nets.
