kpzip/IEEEClock/(commit log)

2025-05-02 ignore kicad
2025-05-03 old schematic
    [clock.kicad_pcb, clock.kicad_sch]
2025-05-08 revision number
    [clock.kicad_pcb]
2025-05-20 avr isp
    [clock.kicad_pcb, clock.kicad_sch]
2025-05-29 archive 1.0 + fixes
    [clock.kicad_pcb, clock.kicad_sch]
2025-05-30 run it back
    [clock.kicad_pcb, clock.kicad_sch]
2025-06-02 Re add fixes
    [clock.kicad_pcb, clock.kicad_sch]
2025-06-02 use pwm again
2025-06-02 set title
    [clock.kicad_sch]
